nico1080/DS4-cirocco-retrofit/CAN ID/can ID.png

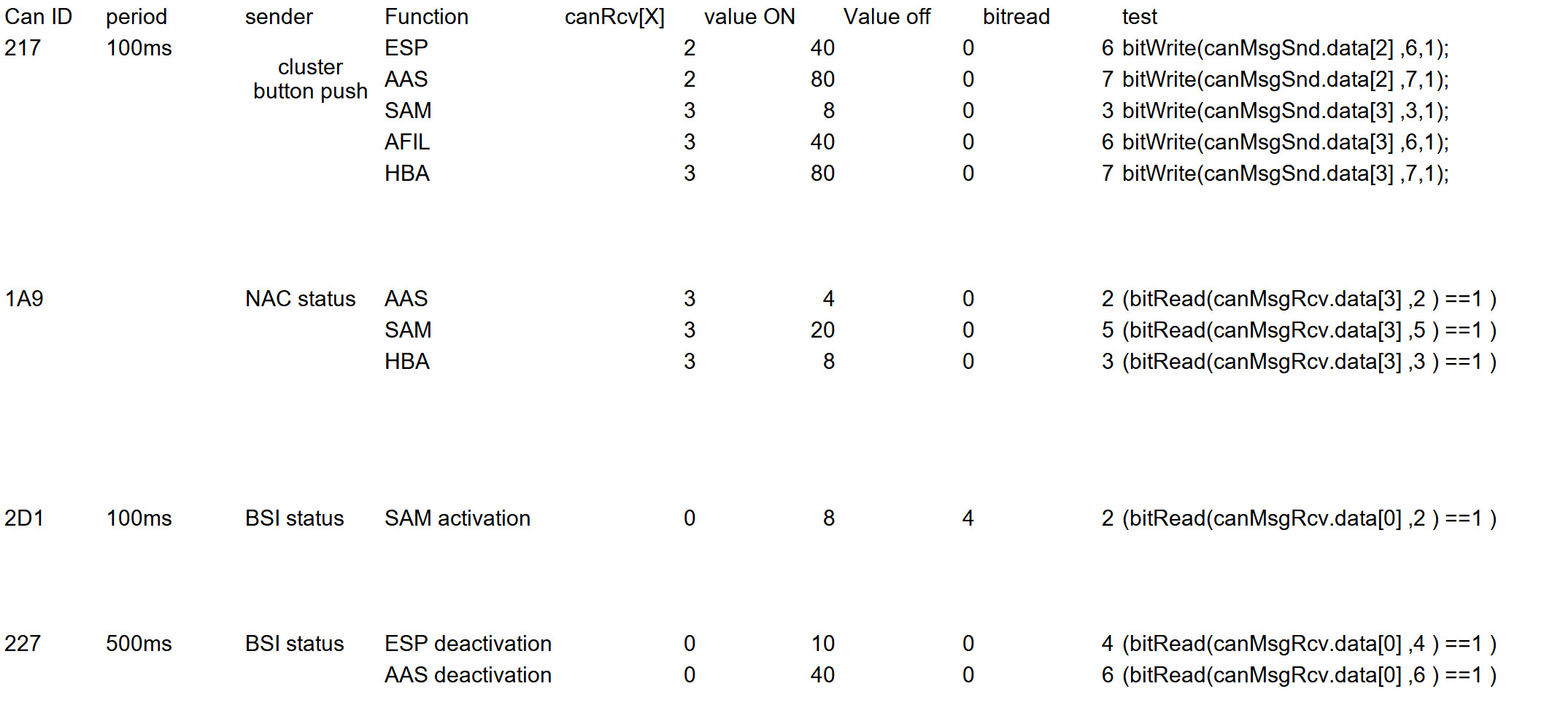
CAN ID/can ID.png
