nico1080/DS4-cirocco-retrofit/Wiring_test/wiring test.jpg

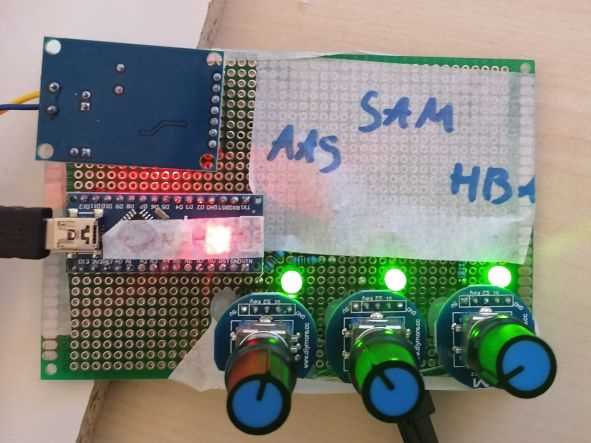
Wiring_test/wiring test.jpg
